IDD-su18/hw3-2001/photos/cntrl.png

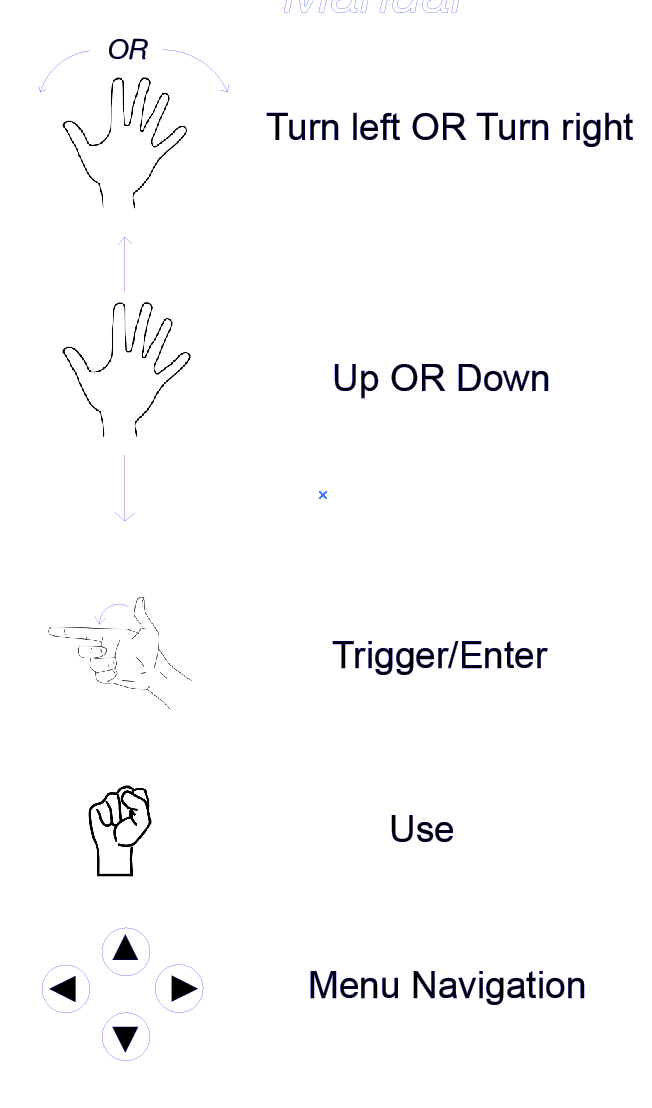
photos/cntrl.png
